mitmedialab/generic-pan-tilt-pcb/generic-pan-tilt-pcb/generic-pan-tilt-pcb.kibot.yaml

# This is a working example.
# For a more complete reference use `--example`
kibot:
  version: 1

global:
  # This will undo the `set_text_variables` when we run it locally
  restore_project: true

import:
# - file: Elecrow
#   definitions:
#     _KIBOT_MANF_DIR: Manufacturers/Elecrow
- file: Elecrow_stencil
  definitions:
    _KIBOT_MANF_DIR: Manufacturers/Elecrow_stencil
# - file: FusionPCB
#   definitions:
#     _KIBOT_MANF_DIR: Manufacturers/FusionPCB
- file: FusionPCB_stencil
  definitions:
    _KIBOT_MANF_DIR: Manufacturers/FusionPCB_stencil
# - file: JLCPCB
#   definitions:
#     _KIBOT_MANF_DIR: Manufacturers/JLCPCB
#     _KIBOT_POS_PRE_TRANSFORM: '[''_kicost_rename'', ''_rot_footprint'']'
#     _KIBOT_BOM_ENABLED: 'false'
# - file: JLCPCB_stencil
#   definitions:
#     _KIBOT_MANF_DIR: Manufacturers/JLCPCB_stencil
#     _KIBOT_POS_PRE_TRANSFORM: '[''_kicost_rename'', ''_rot_footprint'']'
#     _KIBOT_BOM_ENABLED: 'false'
# - file: JLCPCB_with_THT
#   definitions:
#     _KIBOT_MANF_DIR: Manufacturers/JLCPCB_with_THT
#     _KIBOT_POS_PRE_TRANSFORM: '[''_kicost_rename'', ''_rot_footprint'']'
#     _KIBOT_BOM_ENABLED: 'false'
- file: JLCPCB_stencil_with_THT
  definitions:
    _KIBOT_MANF_DIR: Manufacturers/JLCPCB_stencil_with_THT
    _KIBOT_POS_PRE_TRANSFORM: '[''_kicost_rename'', ''_rot_footprint'']'
    _KIBOT_BOM_ENABLED: 'false'
# - file: PCBWay
#   definitions:
#     _KIBOT_MANF_DIR: Manufacturers/PCBWay
- file: PCBWay_stencil
  definitions:
    _KIBOT_MANF_DIR: Manufacturers/PCBWay_stencil
- file: MacroFab_XYRS
  definitions:
    _KIBOT_MPN_FIELD: ''
- file: PCB2Blender_2_7
- file: ExportProject

preflight:
  drc:
    dont_stop: true
    warnings_as_errors: true
    format: HTML,RPT,JSON,CSV
  erc:
    dont_stop: true
    warnings_as_errors: true
    format: HTML,RPT,JSON,CSV
  set_text_variables:
    # The revision will be the short git hash
    # We use ${git_hash} for the REV field in the worksheet (frame)
    - name: 'KIBOT_GIT_DESCRIBE'
      command: |
        git describe --abbrev=7 --dirty --always --tags
    - name: 'KIBOT_GIT_DATE'
      command: |
        git log -1 --format='%as'
      before: 'Commit: '
    # Coherent date and time for the schematic and PCB
    # This will be the time stamp of the files generation, not the commit times
    # We use `${date}` for the time field in the worksheet (frame)
    - name: 'KITBOT_RUN_DATE'
      command: |
        date --iso-8601
      before: 'Compile: '

outputs:
- name: basic_boardview
  comment: Board View export
  type: boardview
  dir: Assembly

# BOM
- name: generic_bom_html
  comment: Generic Bill of Materials in HTML format
  type: bom
  dir: BoM/Generic
  options:
    format: HTML
    count_smd_tht: true
- name: generic_bom_csv
  comment: Generic Bill of Materials in CSV format
  type: bom
  dir: BoM/Generic
  options:
    format: CSV
    count_smd_tht: true
- name: generic_bom_hrtxt
  comment: Generic Bill of Materials in HRTXT format
  type: bom
  dir: BoM/Generic
  options:
    format: HRTXT
    hrtxt:
      separator: '|'
    count_smd_tht: true
- name: generic_bom_tsv
  comment: Generic Bill of Materials in TSV format
  type: bom
  dir: BoM/Generic
  options:
    format: TSV
    count_smd_tht: true
- name: generic_bom_xml
  comment: Generic Bill of Materials in XML format
  type: bom
  dir: BoM/Generic
  options:
    format: XML
    count_smd_tht: true
- name: generic_bom_xlsx
  comment: Generic Bill of Materials in XLSX format
  type: bom
  dir: BoM/Generic
  options:
    format: XLSX
    count_smd_tht: true
- name: positional_bom_html
  comment: Positional Bill of Materials in HTML format
  type: bom
  dir: BoM/Positional
  options:
    format: HTML
    columns: &id001
    - Row
    - Description
    - Part
    - Part Lib
    - References
    - Value
    - Footprint
    - Footprint Lib
    - Quantity Per PCB
    - Build Quantity
    - Status
    - Datasheet
    - Sheetpath
    - Source BoM
    - Footprint X
    - Footprint Y
    - Footprint Rot
    - Footprint Side
    - Footprint Type
    - Footprint Populate
    - Footprint X-Size
    - Footprint Y-Size
    count_smd_tht: true
    html:
      style: modern-red
- name: positional_bom_xlsx
  comment: Positional Bill of Materials in XLSX format
  type: bom
  dir: BoM/Positional
  options:
    format: XLSX
    columns: *id001
    count_smd_tht: true
    xlsx:
      style: modern-red
- name: costs_bom_xlsx
  comment: Costs Bill of Materials in XLSX format
  type: bom
  dir: BoM/Costs
  options:
    format: XLSX
    count_smd_tht: true
    xlsx:
      style: modern-green
      kicost: true
      specs: true
      kicost_api_disable: KitSpace
    pre_transform: _kicost_rename

# Diff
- name: basic_diff_pcb
  comment: PCB diff between the last two changes
  type: diff
  dir: diff
  layers:
  - layer: F.Cu
    suffix: F_Cu
    description: Front copper
  - layer: B.Cu
    suffix: B_Cu
    description: Back copper
  - layer: F.Adhesive
    suffix: F_Adhesive
    description: Front adhesive
  - layer: B.Adhesive
    suffix: B_Adhesive
    description: Back adhesive
  - layer: F.Paste
    suffix: F_Paste
    description: Front solder paste
  - layer: B.Paste
    suffix: B_Paste
    description: Back solder paste
  - layer: F.Silkscreen
    suffix: F_Silkscreen
    description: Front silkscreen (artwork)
  - layer: B.Silkscreen
    suffix: B_Silkscreen
    description: Back silkscreen (artwork)
  - layer: F.Mask
    suffix: F_Mask
    description: Front soldermask (negative)
  - layer: B.Mask
    suffix: B_Mask
    description: Back soldermask (negative)
  - layer: Edge.Cuts
    suffix: Edge_Cuts
    description: Board shape
  - layer: F.Courtyard
    suffix: F_Courtyard
    description: Front courtyard area
  - layer: B.Courtyard
    suffix: B_Courtyard
    description: Back courtyard area
  - layer: F.Fab
    suffix: F_Fab
    description: Front documentation
  - layer: B.Fab
    suffix: B_Fab
    description: Back documentation
  options:
    old: KIBOT_LAST-1
    old_type: git
    new: HEAD
    new_type: git
    cache_dir: /.cache
    add_link_id: true
- name: basic_diff_sch
  comment: Schematic diff between the last two changes
  type: diff
  dir: diff
  options:
    old: KIBOT_LAST-1
    old_type: git
    new: HEAD
    new_type: git
    cache_dir: /.cache
    add_link_id: true
    pcb: false

# Datasheets
# - name: basic_download_datasheets
#   comment: Download the datasheets
#   type: download_datasheets
#   dir: Datasheets

# Gerbers
- name: basic_excellon
  comment: Drill files in EXCELLON format
  type: excellon
  dir: Gerbers_and_Drill
  options:
    map: pdf
- name: basic_gencad
  comment: PCB in GenCAD format
  type: gencad
  dir: Export
- name: basic_gerb_drill
  comment: Drill files in GERB_DRILL format
  type: gerb_drill
  dir: Gerbers_and_Drill
  options:
    map: gerber
- name: gerber_modern
  comment: Gerbers in modern format, recommended by the standard
  type: gerber
  dir: Gerbers_and_Drill
  layers:
  - layer: F.Cu
    suffix: F_Cu
    description: Front copper
  - layer: B.Cu
    suffix: B_Cu
    description: Back copper
  - layer: F.Adhesive
    suffix: F_Adhesive
    description: Front adhesive
  - layer: B.Adhesive
    suffix: B_Adhesive
    description: Back adhesive
  - layer: F.Paste
    suffix: F_Paste
    description: Front solder paste
  - layer: B.Paste
    suffix: B_Paste
    description: Back solder paste
  - layer: F.Silkscreen
    suffix: F_Silkscreen
    description: Front silkscreen (artwork)
  - layer: B.Silkscreen
    suffix: B_Silkscreen
    description: Back silkscreen (artwork)
  - layer: F.Mask
    suffix: F_Mask
    description: Front soldermask (negative)
  - layer: B.Mask
    suffix: B_Mask
    description: Back soldermask (negative)
  - layer: Edge.Cuts
    suffix: Edge_Cuts
    description: Board shape
  - layer: F.Courtyard
    suffix: F_Courtyard
    description: Front courtyard area
  - layer: B.Courtyard
    suffix: B_Courtyard
    description: Back courtyard area
  - layer: F.Fab
    suffix: F_Fab
    description: Front documentation
  - layer: B.Fab
    suffix: B_Fab
    description: Back documentation

# Interactive exports
- name: basic_ibom
  comment: Interactive HTML BoM
  type: ibom
  dir: Assembly
- name: basic_info
  comment: Information about the run
  type: info
  dir: .
- name: basic_kicanvas
  comment: Web page to browse the schematic and/or PCB
  type: kicanvas
  dir: Browse
  options:
    source:
    - schematic
    - pcb
- name: basic_kikit_present
  comment: Simple project presentation
  type: kikit_present
  dir: Presentation
  options:
    description: '# Presentation for generic-pan-tilt-pcb

      This is an automatically generated presentation page'
    boards:
      mode: local
      comment: Resources included
      front_image: renderer_for_present
      back_image: renderer_for_present
      gerbers: gerbers_for_present
- name: renderer_for_present
  comment: Renderer for the presentation
  type: pcbdraw
  dir: Render_for_presentation
  run_by_default: false
- name: gerbers_for_present
  comment: Gerbers for the presentation
  type: gerber
  dir: Gerber_for_presentation
  layers: copper
  run_by_default: false
- name: basic_kiri
  comment: Interactive diff between commits
  type: kiri
  dir: diff
  layers:
  - layer: F.Cu
    suffix: F_Cu
    description: Front copper
  - layer: B.Cu
    suffix: B_Cu
    description: Back copper
  - layer: F.Adhesive
    suffix: F_Adhesive
    description: Front adhesive
  - layer: B.Adhesive
    suffix: B_Adhesive
    description: Back adhesive
  - layer: F.Paste
    suffix: F_Paste
    description: Front solder paste
  - layer: B.Paste
    suffix: B_Paste
    description: Back solder paste
  - layer: F.Silkscreen
    suffix: F_Silkscreen
    description: Front silkscreen (artwork)
  - layer: B.Silkscreen
    suffix: B_Silkscreen
    description: Back silkscreen (artwork)
  - layer: F.Mask
    suffix: F_Mask
    description: Front soldermask (negative)
  - layer: B.Mask
    suffix: B_Mask
    description: Back soldermask (negative)
  - layer: Edge.Cuts
    suffix: Edge_Cuts
    description: Board shape
  - layer: F.Courtyard
    suffix: F_Courtyard
    description: Front courtyard area
  - layer: B.Courtyard
    suffix: B_Courtyard
    description: Back courtyard area
  - layer: F.Fab
    suffix: F_Fab
    description: Front documentation
  - layer: B.Fab
    suffix: B_Fab
    description: Back documentation
  options:
    max_commits: 4
- name: basic_navigate_results
  comment: Web page to browse the results
  type: navigate_results
  dir: Browse
  options:
    link_from_root: index.html
    skip_not_run: true

# Netlists
- name: classic_netlist
  comment: Schematic netlist in KiCad format
  type: netlist
  dir: Export
- name: ipc_netlist
  comment: IPC-D-356 netlist for testing
  type: netlist
  dir: Export
  options:
    format: ipc

# Position
- name: basic_position_ASCII
  comment: Components position for Pick & Place
  type: position
  dir: Position
  options:
    format: ASCII
    only_smd: false
    separate_files_for_front_and_back: false
- name: basic_position_CSV
  comment: Components position for Pick & Place
  type: position
  dir: Position
  options:
    format: CSV
    only_smd: false
    separate_files_for_front_and_back: false

# Reports
- name: report_simple
  comment: Simple design report
  type: report
  output_id: _simple
  options:
    template: simple_ASCII
    do_convert: true
- name: report_full
  comment: Full design report
  type: report
  options:
    template: full_SVG
    do_convert: true

# Schematic export
- name: basic_dxf_sch_print
  comment: Schematic in DXF format
  type: dxf_sch_print
  dir: Schematic
- name: basic_hpgl_sch_print
  comment: Schematic in HPGL format
  type: hpgl_sch_print
  dir: Schematic
- name: basic_pdf_sch_print
  comment: Schematic in PDF format
  type: pdf_sch_print
  dir: Schematic
- name: basic_ps_sch_print
  comment: Schematic in PS format
  type: ps_sch_print
  dir: Schematic
- name: basic_svg_sch_print
  comment: Schematic in SVG format
  type: svg_sch_print
  dir: Schematic

# PCB export
- name: basic_dxf
  comment: Individual layers in DXF format
  type: dxf
  dir: Individual_Layers/DXF
  layers:
  - layer: F.Cu
    suffix: F_Cu
    description: Front copper
  - layer: B.Cu
    suffix: B_Cu
    description: Back copper
  - layer: F.Adhesive
    suffix: F_Adhesive
    description: Front adhesive
  - layer: B.Adhesive
    suffix: B_Adhesive
    description: Back adhesive
  - layer: F.Paste
    suffix: F_Paste
    description: Front solder paste
  - layer: B.Paste
    suffix: B_Paste
    description: Back solder paste
  - layer: F.Silkscreen
    suffix: F_Silkscreen
    description: Front silkscreen (artwork)
  - layer: B.Silkscreen
    suffix: B_Silkscreen
    description: Back silkscreen (artwork)
  - layer: F.Mask
    suffix: F_Mask
    description: Front soldermask (negative)
  - layer: B.Mask
    suffix: B_Mask
    description: Back soldermask (negative)
  - layer: Edge.Cuts
    suffix: Edge_Cuts
    description: Board shape
  - layer: F.Courtyard
    suffix: F_Courtyard
    description: Front courtyard area
  - layer: B.Courtyard
    suffix: B_Courtyard
    description: Back courtyard area
  - layer: F.Fab
    suffix: F_Fab
    description: Front documentation
  - layer: B.Fab
    suffix: B_Fab
    description: Back documentation
- name: basic_hpgl
  comment: Individual layers in HPGL format
  type: hpgl
  dir: Individual_Layers/HPGL
  layers:
  - layer: F.Cu
    suffix: F_Cu
    description: Front copper
  - layer: B.Cu
    suffix: B_Cu
    description: Back copper
  - layer: F.Adhesive
    suffix: F_Adhesive
    description: Front adhesive
  - layer: B.Adhesive
    suffix: B_Adhesive
    description: Back adhesive
  - layer: F.Paste
    suffix: F_Paste
    description: Front solder paste
  - layer: B.Paste
    suffix: B_Paste
    description: Back solder paste
  - layer: F.Silkscreen
    suffix: F_Silkscreen
    description: Front silkscreen (artwork)
  - layer: B.Silkscreen
    suffix: B_Silkscreen
    description: Back silkscreen (artwork)
  - layer: F.Mask
    suffix: F_Mask
    description: Front soldermask (negative)
  - layer: B.Mask
    suffix: B_Mask
    description: Back soldermask (negative)
  - layer: Edge.Cuts
    suffix: Edge_Cuts
    description: Board shape
  - layer: F.Courtyard
    suffix: F_Courtyard
    description: Front courtyard area
  - layer: B.Courtyard
    suffix: B_Courtyard
    description: Back courtyard area
  - layer: F.Fab
    suffix: F_Fab
    description: Front documentation
  - layer: B.Fab
    suffix: B_Fab
    description: Back documentation
- name: basic_pdf
  comment: Individual layers in PDF format
  type: pdf
  dir: Individual_Layers/PDF
  layers:
  - layer: F.Cu
    suffix: F_Cu
    description: Front copper
  - layer: B.Cu
    suffix: B_Cu
    description: Back copper
  - layer: F.Adhesive
    suffix: F_Adhesive
    description: Front adhesive
  - layer: B.Adhesive
    suffix: B_Adhesive
    description: Back adhesive
  - layer: F.Paste
    suffix: F_Paste
    description: Front solder paste
  - layer: B.Paste
    suffix: B_Paste
    description: Back solder paste
  - layer: F.Silkscreen
    suffix: F_Silkscreen
    description: Front silkscreen (artwork)
  - layer: B.Silkscreen
    suffix: B_Silkscreen
    description: Back silkscreen (artwork)
  - layer: F.Mask
    suffix: F_Mask
    description: Front soldermask (negative)
  - layer: B.Mask
    suffix: B_Mask
    description: Back soldermask (negative)
  - layer: Edge.Cuts
    suffix: Edge_Cuts
    description: Board shape
  - layer: F.Courtyard
    suffix: F_Courtyard
    description: Front courtyard area
  - layer: B.Courtyard
    suffix: B_Courtyard
    description: Back courtyard area
  - layer: F.Fab
    suffix: F_Fab
    description: Front documentation
  - layer: B.Fab
    suffix: B_Fab
    description: Back documentation
- name: basic_ps
  comment: Individual layers in PS format
  type: ps
  dir: Individual_Layers/PS
  layers:
  - layer: F.Cu
    suffix: F_Cu
    description: Front copper
  - layer: B.Cu
    suffix: B_Cu
    description: Back copper
  - layer: F.Adhesive
    suffix: F_Adhesive
    description: Front adhesive
  - layer: B.Adhesive
    suffix: B_Adhesive
    description: Back adhesive
  - layer: F.Paste
    suffix: F_Paste
    description: Front solder paste
  - layer: B.Paste
    suffix: B_Paste
    description: Back solder paste
  - layer: F.Silkscreen
    suffix: F_Silkscreen
    description: Front silkscreen (artwork)
  - layer: B.Silkscreen
    suffix: B_Silkscreen
    description: Back silkscreen (artwork)
  - layer: F.Mask
    suffix: F_Mask
    description: Front soldermask (negative)
  - layer: B.Mask
    suffix: B_Mask
    description: Back soldermask (negative)
  - layer: Edge.Cuts
    suffix: Edge_Cuts
    description: Board shape
  - layer: F.Courtyard
    suffix: F_Courtyard
    description: Front courtyard area
  - layer: B.Courtyard
    suffix: B_Courtyard
    description: Back courtyard area
  - layer: F.Fab
    suffix: F_Fab
    description: Front documentation
  - layer: B.Fab
    suffix: B_Fab
    description: Back documentation
- name: basic_svg
  comment: Individual layers in SVG format
  type: svg
  dir: Individual_Layers/SVG
  layers:
  - layer: F.Cu
    suffix: F_Cu
    description: Front copper
  - layer: B.Cu
    suffix: B_Cu
    description: Back copper
  - layer: F.Adhesive
    suffix: F_Adhesive
    description: Front adhesive
  - layer: B.Adhesive
    suffix: B_Adhesive
    description: Back adhesive
  - layer: F.Paste
    suffix: F_Paste
    description: Front solder paste
  - layer: B.Paste
    suffix: B_Paste
    description: Back solder paste
  - layer: F.Silkscreen
    suffix: F_Silkscreen
    description: Front silkscreen (artwork)
  - layer: B.Silkscreen
    suffix: B_Silkscreen
    description: Back silkscreen (artwork)
  - layer: F.Mask
    suffix: F_Mask
    description: Front soldermask (negative)
  - layer: B.Mask
    suffix: B_Mask
    description: Back soldermask (negative)
  - layer: Edge.Cuts
    suffix: Edge_Cuts
    description: Board shape
  - layer: F.Courtyard
    suffix: F_Courtyard
    description: Front courtyard area
  - layer: B.Courtyard
    suffix: B_Courtyard
    description: Back courtyard area
  - layer: F.Fab
    suffix: F_Fab
    description: Front documentation
  - layer: B.Fab
    suffix: B_Fab
    description: Back documentation
- name: basic_pcb_print_pdf
  comment: PCB
  type: pcb_print
  dir: PCB/PDF
  options:
    format: PDF
    pages:
    - layers:
      - layer: F.Cu
      - layer: F.Mask
        color: '#14332440'
      - layer: F.Paste
      - layer: F.Silkscreen
      - layer: Edge.Cuts
      sheet: Front copper
    - layers:
      - layer: B.Cu
      - layer: B.Mask
        color: '#14332440'
      - layer: B.Paste
      - layer: B.Silkscreen
      - layer: Edge.Cuts
      sheet: Back copper
    - layers:
      - layer: F.Courtyard
      - layer: Edge.Cuts
      sheet: Front courtyard area
    - layers:
      - layer: B.Courtyard
      - layer: Edge.Cuts
      sheet: Back courtyard area
    - layers:
      - layer: F.Fab
      - layer: Edge.Cuts
      sheet: Front documentation
    - layers:
      - layer: B.Fab
      - layer: Edge.Cuts
      sheet: Back documentation
    keep_temporal_files: true
- name: basic_pcb_print_svg
  comment: PCB
  type: pcb_print
  dir: PCB/SVG
  options:
    format: SVG
    pages:
    - layers:
      - layer: F.Cu
      - layer: F.Mask
        color: '#14332440'
      - layer: F.Paste
      - layer: F.Silkscreen
      - layer: Edge.Cuts
      sheet: Front copper
    - layers:
      - layer: B.Cu
      - layer: B.Mask
        color: '#14332440'
      - layer: B.Paste
      - layer: B.Silkscreen
      - layer: Edge.Cuts
      sheet: Back copper
    - layers:
      - layer: F.Courtyard
      - layer: Edge.Cuts
      sheet: Front courtyard area
    - layers:
      - layer: B.Courtyard
      - layer: Edge.Cuts
      sheet: Back courtyard area
    - layers:
      - layer: F.Fab
      - layer: Edge.Cuts
      sheet: Front documentation
    - layers:
      - layer: B.Fab
      - layer: Edge.Cuts
      sheet: Back documentation
    keep_temporal_files: true
    add_background: true
- name: basic_pcb_print_png
  comment: PCB
  type: pcb_print
  dir: PCB/PNG
  options:
    format: PNG
    pages:
    - layers:
      - layer: F.Cu
      - layer: F.Mask
        color: '#14332440'
      - layer: F.Paste
      - layer: F.Silkscreen
      - layer: Edge.Cuts
      sheet: Front copper
    - layers:
      - layer: B.Cu
      - layer: B.Mask
        color: '#14332440'
      - layer: B.Paste
      - layer: B.Silkscreen
      - layer: Edge.Cuts
      sheet: Back copper
    - layers:
      - layer: F.Courtyard
      - layer: Edge.Cuts
      sheet: Front courtyard area
    - layers:
      - layer: B.Courtyard
      - layer: Edge.Cuts
      sheet: Back courtyard area
    - layers:
      - layer: F.Fab
      - layer: Edge.Cuts
      sheet: Front documentation
    - layers:
      - layer: B.Fab
      - layer: Edge.Cuts
      sheet: Back documentation
    keep_temporal_files: true
    add_background: true
- name: basic_pcb_print_eps
  comment: PCB
  type: pcb_print
  dir: PCB/EPS
  options:
    format: EPS
    pages:
    - layers:
      - layer: F.Cu
      - layer: F.Mask
        color: '#14332440'
      - layer: F.Paste
      - layer: F.Silkscreen
      - layer: Edge.Cuts
      sheet: Front copper
    - layers:
      - layer: B.Cu
      - layer: B.Mask
        color: '#14332440'
      - layer: B.Paste
      - layer: B.Silkscreen
      - layer: Edge.Cuts
      sheet: Back copper
    - layers:
      - layer: F.Courtyard
      - layer: Edge.Cuts
      sheet: Front courtyard area
    - layers:
      - layer: B.Courtyard
      - layer: Edge.Cuts
      sheet: Back courtyard area
    - layers:
      - layer: F.Fab
      - layer: Edge.Cuts
      sheet: Front documentation
    - layers:
      - layer: B.Fab
      - layer: Edge.Cuts
      sheet: Back documentation
    keep_temporal_files: true
- name: basic_pcb_print_ps
  comment: PCB
  type: pcb_print
  dir: PCB/PS
  options:
    format: PS
    pages:
    - layers:
      - layer: F.Cu
      - layer: F.Mask
        color: '#14332440'
      - layer: F.Paste
      - layer: F.Silkscreen
      - layer: Edge.Cuts
      sheet: Front copper
    - layers:
      - layer: B.Cu
      - layer: B.Mask
        color: '#14332440'
      - layer: B.Paste
      - layer: B.Silkscreen
      - layer: Edge.Cuts
      sheet: Back copper
    - layers:
      - layer: F.Courtyard
      - layer: Edge.Cuts
      sheet: Front courtyard area
    - layers:
      - layer: B.Courtyard
      - layer: Edge.Cuts
      sheet: Back courtyard area
    - layers:
      - layer: F.Fab
      - layer: Edge.Cuts
      sheet: Front documentation
    - layers:
      - layer: B.Fab
      - layer: Edge.Cuts
      sheet: Back documentation
    keep_temporal_files: true

# Stencil
- name: basic_stencil_3d
  comment: 3D self-registering stencil
  type: stencil_3d
  dir: Assembly
- name: basic_stencil_for_jig
  comment: Steel stencil for alignment jig
  type: stencil_for_jig
  dir: Assembly
  options:
    jigwidth: 100
    jigheight: 100

# 2D render
# - name: basic_pcbdraw_svg_jlcpcb_green_enig_top
#   comment: PCB 2D render in SVG format, using jlcpcb-green-enig style
#   type: pcbdraw
#   dir: PCB/2D_render/jlcpcb_green_enig
#   options:
#     style: jlcpcb-green-enig
#     format: svg
# - name: basic_pcbdraw_png_jlcpcb_green_enig_top
#   comment: PCB 2D render in PNG format, using jlcpcb-green-enig style
#   type: pcbdraw
#   dir: PCB/2D_render/jlcpcb_green_enig
#   options:
#     style: jlcpcb-green-enig
#     format: png
# - name: basic_pcbdraw_jpg_jlcpcb_green_enig_top
#   comment: PCB 2D render in JPG format, using jlcpcb-green-enig style
#   type: pcbdraw
#   dir: PCB/2D_render/jlcpcb_green_enig
#   options:
#     style: jlcpcb-green-enig
#     format: jpg
# - name: basic_pcbdraw_svg_set_blue_enig_top
#   comment: PCB 2D render in SVG format, using set-blue-enig style
#   type: pcbdraw
#   dir: PCB/2D_render/set_blue_enig
#   options:
#     style: set-blue-enig
#     format: svg
# - name: basic_pcbdraw_png_set_blue_enig_top
#   comment: PCB 2D render in PNG format, using set-blue-enig style
#   type: pcbdraw
#   dir: PCB/2D_render/set_blue_enig
#   options:
#     style: set-blue-enig
#     format: png
# - name: basic_pcbdraw_jpg_set_blue_enig_top
#   comment: PCB 2D render in JPG format, using set-blue-enig style
#   type: pcbdraw
#   dir: PCB/2D_render/set_blue_enig
#   options:
#     style: set-blue-enig
#     format: jpg
# - name: basic_pcbdraw_svg_set_red_hasl_top
#   comment: PCB 2D render in SVG format, using set-red-hasl style
#   type: pcbdraw
#   dir: PCB/2D_render/set_red_hasl
#   options:
#     style: set-red-hasl
#     format: svg
# - name: basic_pcbdraw_png_set_red_hasl_top
#   comment: PCB 2D render in PNG format, using set-red-hasl style
#   type: pcbdraw
#   dir: PCB/2D_render/set_red_hasl
#   options:
#     style: set-red-hasl
#     format: png
# - name: basic_pcbdraw_jpg_set_red_hasl_top
#   comment: PCB 2D render in JPG format, using set-red-hasl style
#   type: pcbdraw
#   dir: PCB/2D_render/set_red_hasl
#   options:
#     style: set-red-hasl
#     format: jpg

# 3D export
# - name: basic_step
#   comment: 3D model in STEP format
#   type: step
#   dir: 3D
# - name: basic_vrml
#   comment: PCB in VRML format
#   type: vrml
#   dir: 3D
#
# # 3D render
# - name: basic_render_3d_top
#   comment: 3D view from top
#   type: render_3d
#   dir: 3D
#   options:
#     ray_tracing: true
#     orthographic: true
# - name: basic_render_3d_30deg
#   comment: 3D view from 30 degrees
#   type: render_3d
#   dir: 3D
#   output_id: 30deg
#   options:
#     ray_tracing: true
#     rotate_x: 3
#     rotate_z: -2
# - name: basic_blender_export
#   comment: 3D view from top/30 deg/bottom (Blender)
#   type: blender_export
#   dir: 3D
#   options:
#     pcb3d: _PCB2Blender_2_7
#     outputs:
#     - type: render
#     - type: blender
#     point_of_view:
#     - view: top
#     - rotate_x: 30
#       rotate_z: -20
#       file_id: _30deg

...
definitions:
  _KIBOT_MANF_DIR_COMP: Manufacturers
  _KIBOT_GERBER_LAYERS: "- layer: 'F.Cu'\n        suffix: 'F_Cu'\n        description:\
    \ 'Front copper'\n      - layer: 'F.Paste'\n        suffix: 'F_Paste'\n      \
    \  description: 'Front solder paste'\n      - layer: 'F.Silkscreen'\n        suffix:\
    \ 'F_Silkscreen'\n        description: 'Front silkscreen (artwork)'\n      - layer:\
    \ 'F.Mask'\n        suffix: 'F_Mask'\n        description: 'Front soldermask (negative)'\n\
    \      - layer: 'Edge.Cuts'\n        suffix: 'Edge_Cuts'\n        description:\
    \ 'Board shape'"
