mitmedialab/generic-pan-tilt-pcb/(commit log)

2024-07-12 initial kibot
    [pan-tilt-pcb.kicad_pcb, pan-tilt-pcb.kicad_sch, pan-tilt_24v_to_3.3v.kicad_sch, pan-tilt_accelerometer.kicad_sch, pan-tilt_dmx-expansion.kicad_sch, pan-tilt_hid.kicad_sch, pan-tilt_rp2040.kicad_sch, pan-tilt_rs485.kicad_sch]
2024-07-16 fix missing pieces, incorporate review feedback
    [pan-tilt-pcb.kicad_sch, pan-tilt_24v_to_3.3v.kicad_sch, pan-tilt_accelerometer.kicad_sch, pan-tilt_dmx-expansion.kicad_sch, pan-tilt_hid.kicad_sch, pan-tilt_rp2040.kicad_sch]
2024-07-16 rename to pan-tilt-pcb everywhere
    [pan-tilt-pcb.kicad_sch, pan-tilt-pcb_24v_to_3.3v.kicad_sch, pan-tilt-pcb_accelerometer.kicad_sch, pan-tilt-pcb_dmx-expansion.kicad_sch, pan-tilt-pcb_hid.kicad_sch, pan-tilt-pcb_rp2040.kicad_sch, pan-tilt-pcb_rs485.kicad_sch]
2024-07-16 add other boards
    [generic-pan-tilt-home-sensor-pcb.kicad_pcb, generic-pan-tilt-home-sensor-pcb.kicad_sch, generic-pan-tilt-motor-pcb.kicad_pcb, generic-pan-tilt-motor-pcb.kicad_sch, generic-pan-tilt-motor-pcb_driver.kicad_sch, generic-pan-tilt-motor-pcb_encoder.kicad_sch, generic-pan-tilt-motor-pcb_io.kicad_sch]
2024-07-18 pick all footprints, begin layout
    [generic-pan-tilt-pcb.kicad_pcb, generic-pan-tilt-pcb.kicad_sch, generic-pan-tilt-pcb_24v_to_3.3v.kicad_sch, generic-pan-tilt-pcb_accelerometer.kicad_sch, generic-pan-tilt-pcb_dmx-expansion.kicad_sch, generic-pan-tilt-pcb_hid.kicad_sch, generic-pan-tilt-pcb_rp2040.kicad_sch, generic-pan-tilt-pcb_rs485.kicad_sch]
2024-07-19 layout progress
    [generic-pan-tilt-pcb.kicad_pcb, generic-pan-tilt-pcb_24v_to_3.3v.kicad_sch, generic-pan-tilt-pcb_rp2040.kicad_sch, generic-pan-tilt-pcb_rs485.kicad_sch]
2024-07-19 more progress
    [generic-pan-tilt-pcb.kicad_pcb, generic-pan-tilt-pcb.kicad_sch, generic-pan-tilt-pcb_hid.kicad_sch, generic-pan-tilt-pcb_rs485.kicad_sch]
2024-07-19 a very stubborn time feels very accurate
    [generic-pan-tilt-pcb.kicad_pcb]
2024-07-20 make board bigger
    [generic-pan-tilt-pcb.kicad_pcb]
2024-07-20 begin new routing
    [generic-pan-tilt-pcb.kicad_pcb, generic-pan-tilt-pcb.kicad_sch, generic-pan-tilt-pcb_24v_to_3.3v.kicad_sch, generic-pan-tilt-pcb_accelerometer.kicad_sch, generic-pan-tilt-pcb_dmx-expansion.kicad_sch, generic-pan-tilt-pcb_hid.kicad_sch, generic-pan-tilt-pcb_rp2040.kicad_sch, generic-pan-tilt-pcb_rs485.kicad_sch]
2024-07-20 fix kibot fetch depth for diff
    [generic-pan-tilt-motor-pcb.kibot.yaml]
2024-07-21 more pcb, kicost maf digikey mouser
    [generic-pan-tilt-pcb.kicad_pcb, generic-pan-tilt-pcb.kicad_sch, generic-pan-tilt-pcb_24v_to_3.3v.kicad_sch, generic-pan-tilt-pcb_accelerometer.kicad_sch, generic-pan-tilt-pcb_hid.kicad_sch, generic-pan-tilt-pcb_rp2040.kicad_sch, generic-pan-tilt-pcb_rs485.kicad_sch]
2024-07-21 transplant hardware guide rp2040
    [generic-pan-tilt-pcb.kicad_pcb, generic-pan-tilt-pcb_rp2040.kicad_sch]
2024-07-22 mostly done with rp2040, horizontal usb
    [generic-pan-tilt-pcb.kicad_pcb, generic-pan-tilt-pcb.kicad_sch, generic-pan-tilt-pcb_rp2040.kicad_sch]
2024-07-22 finish rp2040 layout
    [generic-pan-tilt-pcb.kicad_pcb, generic-pan-tilt-pcb_dmx-expansion.kicad_sch]
2024-07-22 route rs485
    [generic-pan-tilt-pcb.kicad_pcb]
2024-07-22 route 3v3 reg, move vh connector
    [generic-pan-tilt-pcb.kicad_pcb]
2024-07-22 rotate vh connector, stitch rs485
    [generic-pan-tilt-pcb.kicad_pcb]
2024-07-22 add more fiducials
    [generic-pan-tilt-pcb.kicad_pcb, generic-pan-tilt-pcb.kicad_sch]
2024-07-22 routing done, add oshw and license
    [generic-pan-tilt-pcb.kicad_pcb, generic-pan-tilt-pcb.kicad_sch, generic-pan-tilt-pcb_24v_to_3.3v.kicad_sch, generic-pan-tilt-pcb_accelerometer.kicad_sch, generic-pan-tilt-pcb_dmx-expansion.kicad_sch, generic-pan-tilt-pcb_hid.kicad_sch, generic-pan-tilt-pcb_rp2040.kicad_sch, generic-pan-tilt-pcb_rs485.kicad_sch]
2024-07-23 dippity dip dip dip chip
    [generic-pan-tilt-pcb.kicad_pcb, generic-pan-tilt-pcb.kicad_sch, generic-pan-tilt-pcb_hid.kicad_sch]
2024-07-23 fix all drc and erc
    [generic-pan-tilt-pcb.kicad_pcb, generic-pan-tilt-pcb_rp2040.kicad_sch]
2024-07-23 fix iso supply collision
    [generic-pan-tilt-pcb.kicad_pcb]
2024-07-23 kibot erc drc exclusions workaround
    [generic-pan-tilt-motor-pcb.kibot.yaml]
2024-07-24 try auto date and describe revision
    [generic-pan-tilt-pcb.kicad_pcb, generic-pan-tilt-pcb.kicad_sch, generic-pan-tilt-pcb_24v_to_3.3v.kicad_sch, generic-pan-tilt-pcb_accelerometer.kicad_sch, generic-pan-tilt-pcb_dmx-expansion.kicad_sch, generic-pan-tilt-pcb_hid.kicad_sch, generic-pan-tilt-pcb_rp2040.kicad_sch, generic-pan-tilt-pcb_rs485.kicad_sch]
2024-07-24 kibot try removing drc manual filters
2024-07-24 PCB on US Letter
    [generic-pan-tilt-pcb.kicad_pcb]
2024-07-24 fix overlap in kibot vars
    [generic-pan-tilt-pcb.kicad_pcb]
2024-07-24 saving exclusions requries closing schematic/board
2024-07-24 erc drc warnings as errors, fix date overlap
    [generic-pan-tilt-pcb.kibot.yaml]
2024-07-24 fix usb drc errors
    [generic-pan-tilt-pcb.kicad_pcb, generic-pan-tilt-pcb.kicad_sch]
2024-07-24 fix LED resistors
    [generic-pan-tilt-pcb.kicad_pcb, generic-pan-tilt-pcb_24v_to_3.3v.kicad_sch, generic-pan-tilt-pcb_hid.kicad_sch, generic-pan-tilt-pcb_rs485.kicad_sch]
2024-07-24 kibot remove qr, organize yaml, add more pcb fab templates
2024-07-24 kibot remove qr, organize yaml, add more pcb fab templates typo
2024-07-24 organize yaml more, fix blender output
    [generic-pan-tilt-pcb.kibot.yaml]
2024-07-24 fix c footprint for r
    [generic-pan-tilt-pcb.kicad_pcb, generic-pan-tilt-pcb.kicad_sch, generic-pan-tilt-pcb_hid.kicad_sch, generic-pan-tilt-pcb_rp2040.kicad_sch]
2024-07-24 0603 caps for psu rs485
    [generic-pan-tilt-pcb.kicad_pcb, generic-pan-tilt-pcb.kicad_sch, generic-pan-tilt-pcb_24v_to_3.3v.kicad_sch, generic-pan-tilt-pcb_rp2040.kicad_sch, generic-pan-tilt-pcb_rs485.kicad_sch]
2024-07-24 motor pcb all footprints, ov circuit
    [generic-pan-tilt-motor-pcb.kicad_pcb, generic-pan-tilt-motor-pcb.kicad_sch, generic-pan-tilt-motor-pcb_driver.kicad_sch, generic-pan-tilt-motor-pcb_encoder.kicad_sch, generic-pan-tilt-motor-pcb_io.kicad_sch]
2024-07-25 motor reorder enc connector
    [generic-pan-tilt-motor-pcb.kicad_sch]
2024-07-26 motor basic layout
    [generic-pan-tilt-motor-pcb.kicad_pcb, generic-pan-tilt-motor-pcb.kicad_sch, generic-pan-tilt-motor-pcb_driver.kicad_sch, generic-pan-tilt-motor-pcb_encoder.kicad_sch, generic-pan-tilt-motor-pcb_io.kicad_sch]
2024-07-30 motor pcb layout up to enc filter
    [generic-pan-tilt-motor-pcb.kicad_pcb, generic-pan-tilt-motor-pcb_encoder.kicad_sch, generic-pan-tilt-motor-pcb_io.kicad_sch]
2024-08-05 motor all placed
    [generic-pan-tilt-motor-pcb.kicad_pcb]
2024-08-07 motor silkscreen done
    [generic-pan-tilt-motor-pcb.kicad_pcb]
2024-08-07 motor resolve all drc
    [generic-pan-tilt-motor-pcb.kicad_pcb]
2024-08-07 layout home sensor
    [generic-pan-tilt-home-sensor-pcb.kicad_pcb, generic-pan-tilt-home-sensor-pcb.kicad_sch]
2024-08-08 reduce home sensor board 1mm
    [generic-pan-tilt-home-sensor-pcb.kicad_pcb]
2024-08-08 add model def for 4 pin jst ph, add more motor gnd vias, align motor 12 pin connector
    [generic-pan-tilt-home-sensor-pcb.kicad_pcb, generic-pan-tilt-motor-pcb.kicad_pcb]
2024-08-08 generic-pan-tilt update fill, fix C26 silk
    [generic-pan-tilt-pcb.kicad_pcb]
2024-08-09 move led and dip, add hole
    [generic-pan-tilt-pcb.kicad_pcb, generic-pan-tilt-pcb.kicad_sch]
2024-08-10 shift additional dip mount hole more
    [generic-pan-tilt-pcb.kicad_pcb]
2024-08-10 kibot update other boards, fix commit date
    [generic-pan-tilt-motor-pcb.kibot.yaml]
2024-08-11 motor pcb vssop pad clearance increase to 0.19mm for pcbway soldermask
    [generic-pan-tilt-motor-pcb.kicad_pcb]
2024-08-12 main pcb increase cutouts to 0.8mm pcbway
    [generic-pan-tilt-pcb.kicad_pcb]
2024-08-25 fix part numbers, add newark parts, separate fields for part desc
    [generic-pan-tilt-home-sensor-pcb.kicad_sch, generic-pan-tilt-motor-pcb.kicad_sch, generic-pan-tilt-motor-pcb_driver.kicad_sch, generic-pan-tilt-motor-pcb_encoder.kicad_sch, generic-pan-tilt-motor-pcb_io.kicad_sch, generic-pan-tilt-pcb.kicad_sch, generic-pan-tilt-pcb_24v_to_3.3v.kicad_sch, generic-pan-tilt-pcb_accelerometer.kicad_sch]
2024-08-25 home sensor 0603 cap, flip conn, more part numbers
    [generic-pan-tilt-home-sensor-pcb.kicad_pcb, generic-pan-tilt-home-sensor-pcb.kicad_sch]
2024-08-25 motor fix flipped spi mcp, spi tristate for drc, silk screw terminals, all parts manf and vendors
    [generic-pan-tilt-motor-pcb.kicad_pcb, generic-pan-tilt-motor-pcb.kicad_sch, generic-pan-tilt-motor-pcb_driver.kicad_sch, generic-pan-tilt-motor-pcb_encoder.kicad_sch, generic-pan-tilt-motor-pcb_io.kicad_sch]
2024-08-25 main board fix usb, fix uart, all caps and resistors manf and vendor, sch only replace psu and accel caps
    [generic-pan-tilt-pcb.kicad_pcb, generic-pan-tilt-pcb.kicad_sch, generic-pan-tilt-pcb_24v_to_3.3v.kicad_sch, generic-pan-tilt-pcb_accelerometer.kicad_sch, generic-pan-tilt-pcb_hid.kicad_sch, generic-pan-tilt-pcb_rp2040.kicad_sch, generic-pan-tilt-pcb_rs485.kicad_sch]
2024-08-26 main pcb re-layout caps, add some silk pin and conn labels, move vias away from orientation markers
    [generic-pan-tilt-pcb.kicad_pcb, generic-pan-tilt-pcb_accelerometer.kicad_sch]
2024-08-26 kibot disable blender and 2d renders
    [generic-pan-tilt-motor-pcb.kibot.yaml]
2024-08-26 kibot no datasheets or any render to speed up
    [generic-pan-tilt-motor-pcb.kibot.yaml]
2024-08-26 main fix mouser part extra space
    [generic-pan-tilt-pcb.kicad_pcb, generic-pan-tilt-pcb_hid.kicad_sch]
2024-08-26 fix inductor value, fix erc
    [generic-pan-tilt-pcb.kicad_pcb, generic-pan-tilt-pcb_24v_to_3.3v.kicad_sch]
2024-08-26 main dnp headers
    [generic-pan-tilt-pcb.kicad_pcb, generic-pan-tilt-pcb_dmx-expansion.kicad_sch]
2024-08-26 motor board fix fields, add drc exclusion
    [generic-pan-tilt-motor-pcb.kicad_pcb, generic-pan-tilt-motor-pcb_driver.kicad_sch, generic-pan-tilt-motor-pcb_encoder.kicad_sch]
2024-08-26 home sensor rev silk length
    [generic-pan-tilt-home-sensor-pcb.kicad_pcb]
2024-08-27 main accel fix footprint
    [generic-pan-tilt-pcb.kicad_pcb, generic-pan-tilt-pcb_accelerometer.kicad_sch]
2024-08-27 motor fix incorrect cap part
    [generic-pan-tilt-motor-pcb.kicad_pcb, generic-pan-tilt-motor-pcb.kicad_sch]
